magnusnoob/MUP/Hardware.pdf

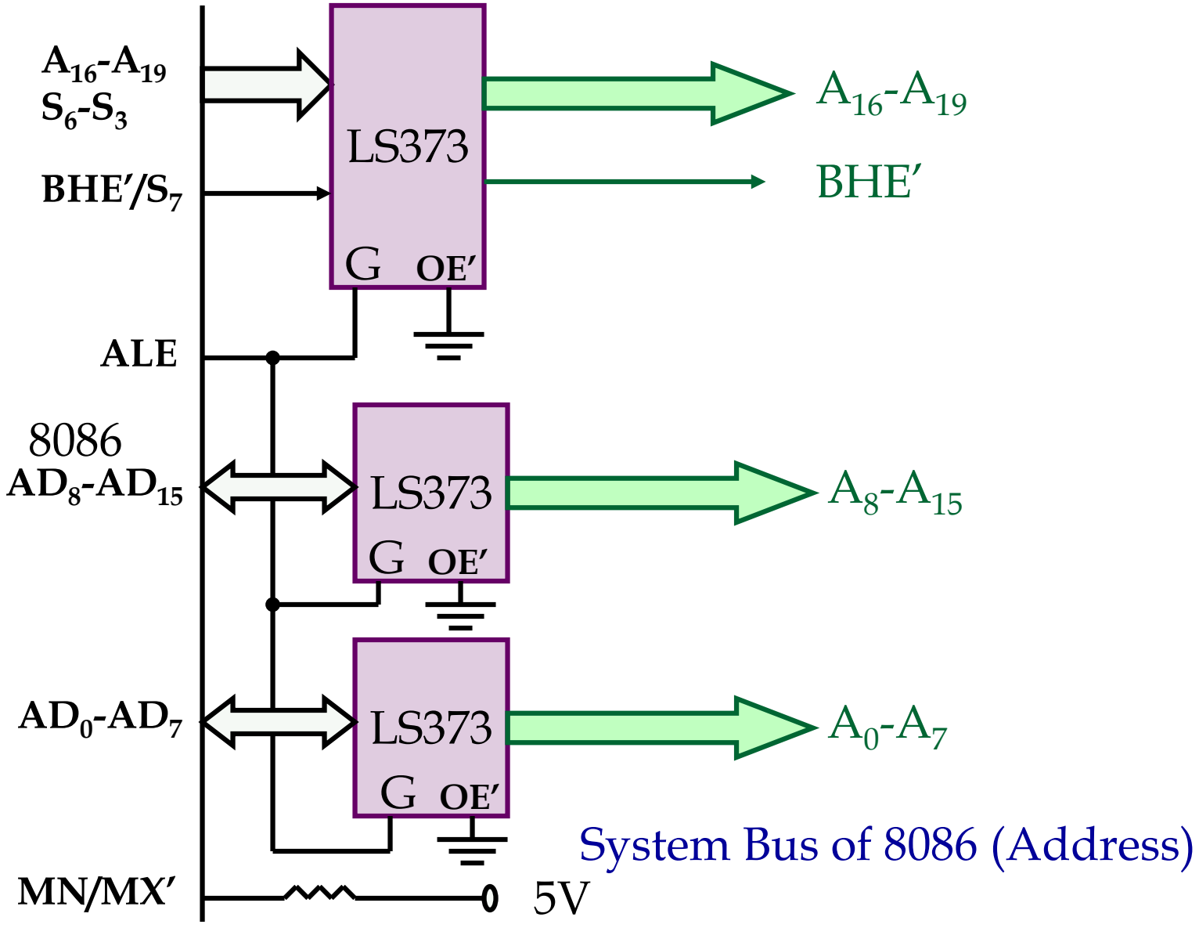
[picture p6: figure]
BHE’/S7; ALE; BHE’; System Bus of 8086 (Address)

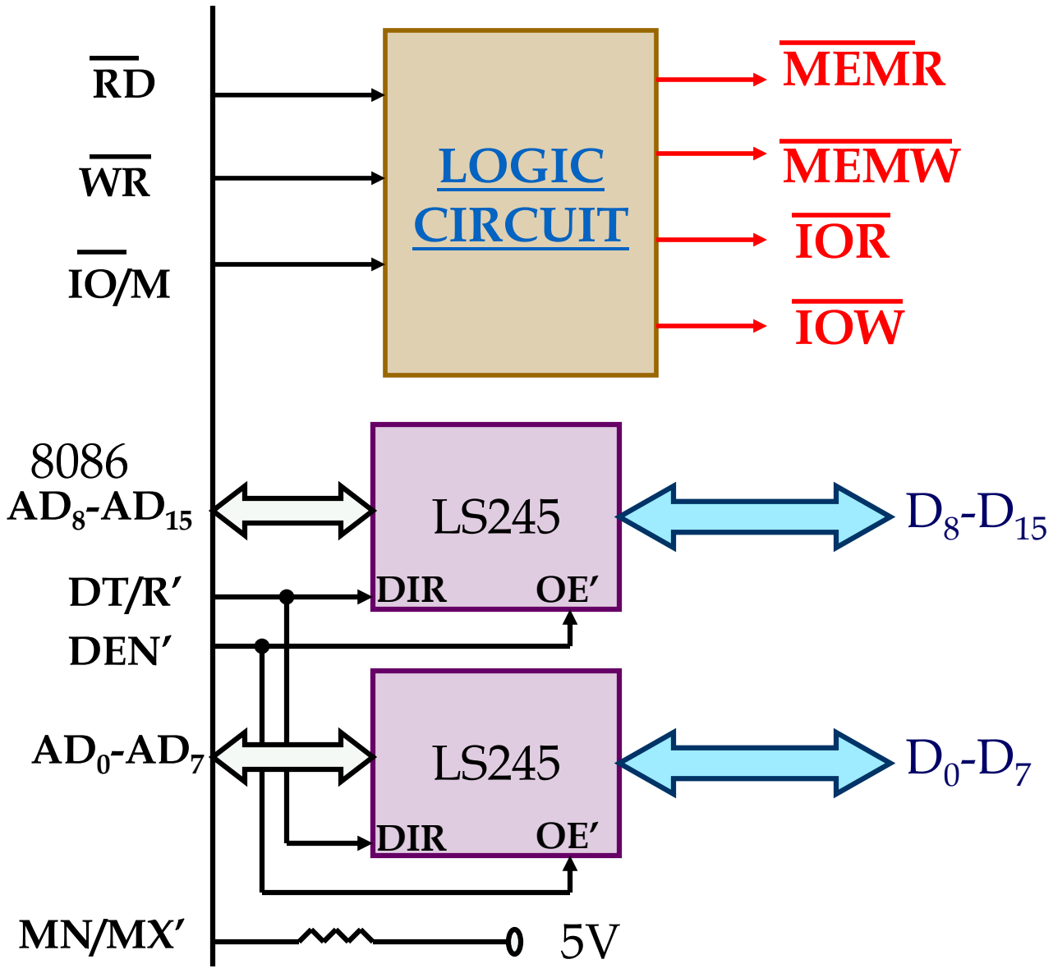
[picture p7: figure]
DIR; DT/R’ DEN’; MEMR; MEMW; IOR; IOW; LOGIC CIRCUIT

System Bus of 8086(Data + Control)

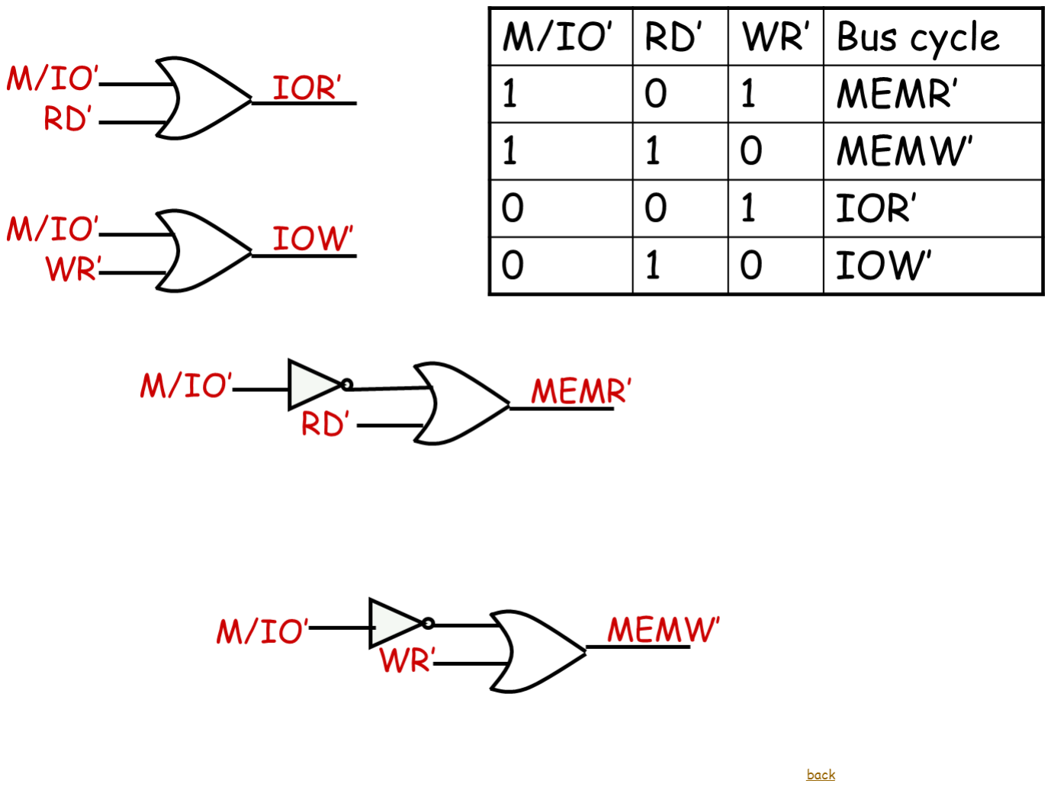
[picture p8: page 3]

LS138

GND

G2A G1

GND G2B

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
MEMW’

BHE’
MEMW’

WRL’

WRH’

Memory Decoder

A0
MEMR’

RDL’

BHE’
MEMR’

RDH’

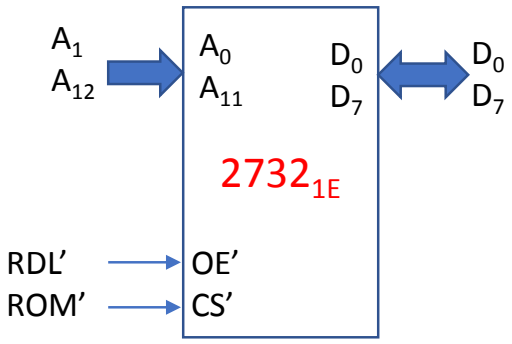
[picture p9: figure]
RDL’ ROM’
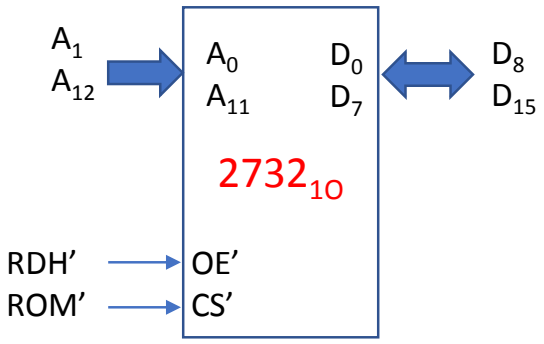
[picture p10: figure]
RDH’ ROM’

Memory Interfacing

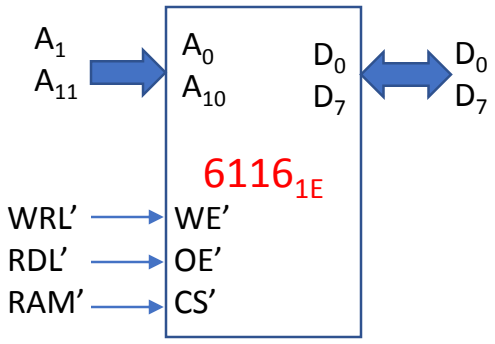
[picture p11: figure]
WRL’ RDL’ RAM’
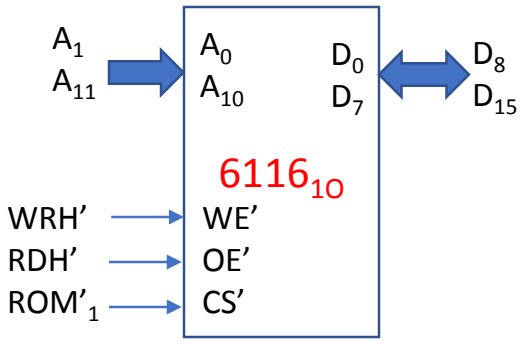
[picture p12: figure]
WRH’ RDH’ ROM’1

LS138

A6

G2A G1

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
8255 C CS’

O0

O3

8255 A CS’

8253 CS’

M/IO

VCC

I/O Decoder

O1

O4
O5
O6

8255 B CS’

8255 D CS’

8255 E CS’
INTCTR

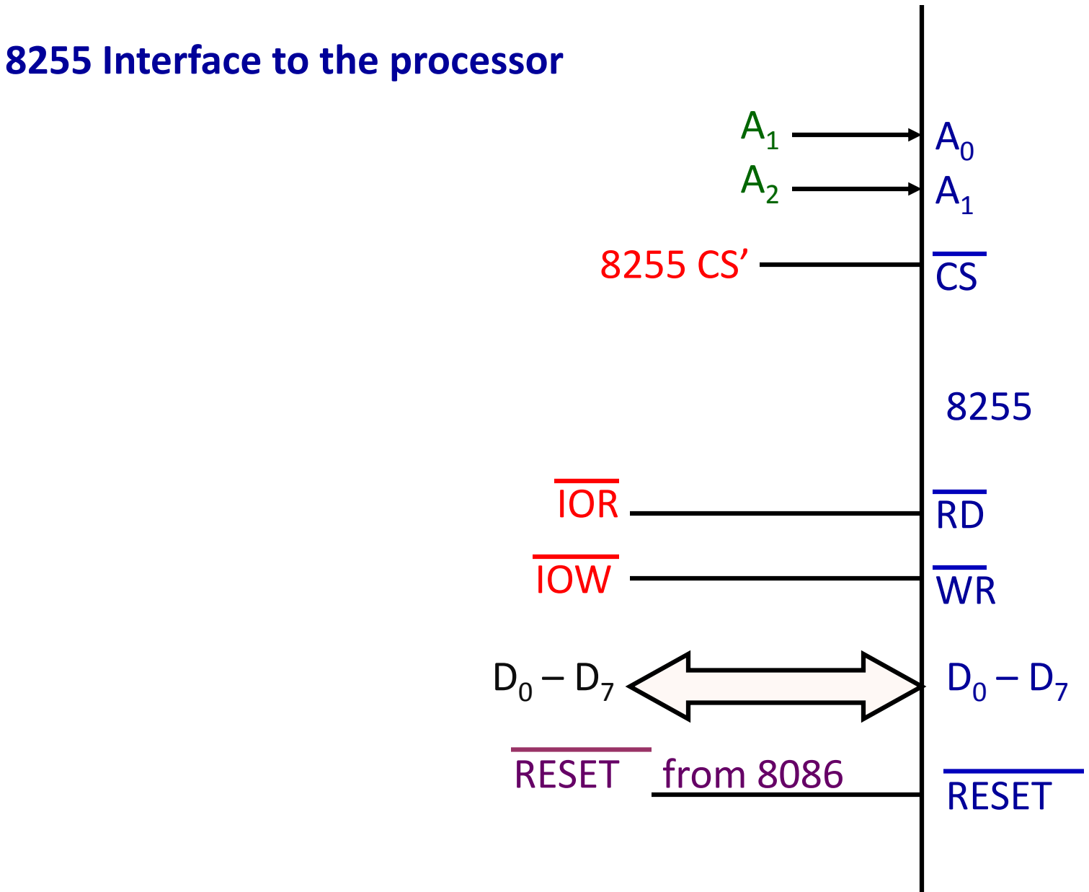
[picture p13: figure]
8255 Interface to the processor; IOR; IOW; RESET RESET from 8086
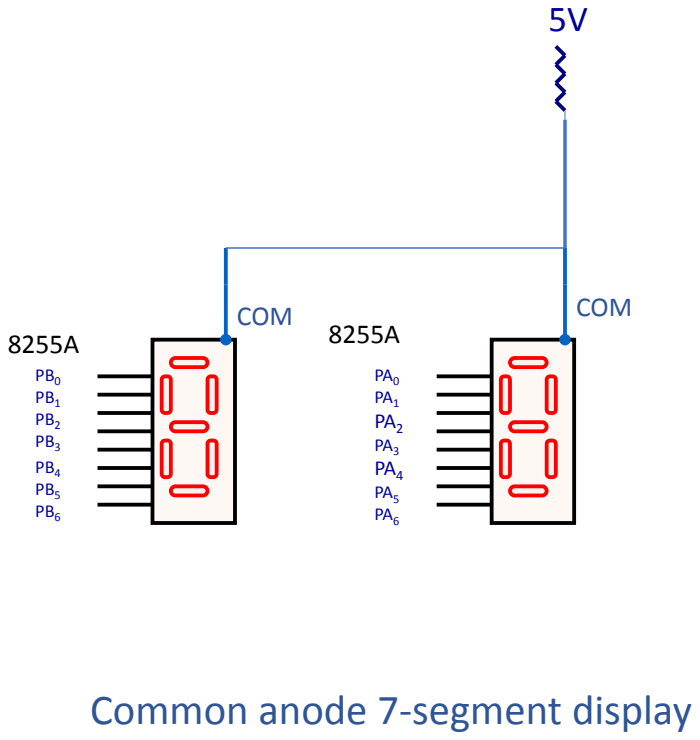
[picture p14: page 8]
COM

Common anode 7-segment display

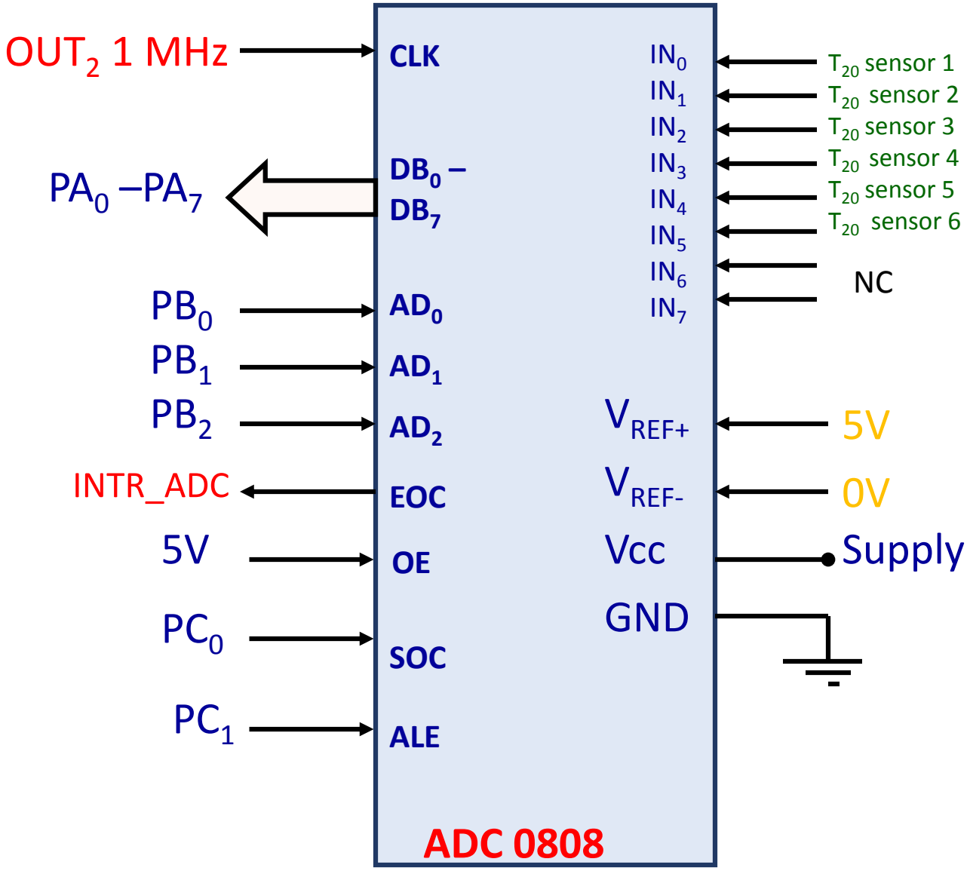
[picture p15: figure]
ADC 0808; T20 sensor 1 T20 sensor 2 T20 sensor 3 T20 sensor 4 T20 sensor 5 T20 sensor 6; OUT2 1 MHz; CLK; VREF+; VREF-; Vcc; GND; Supply; EOC INTR_ADC; SOC; ALE

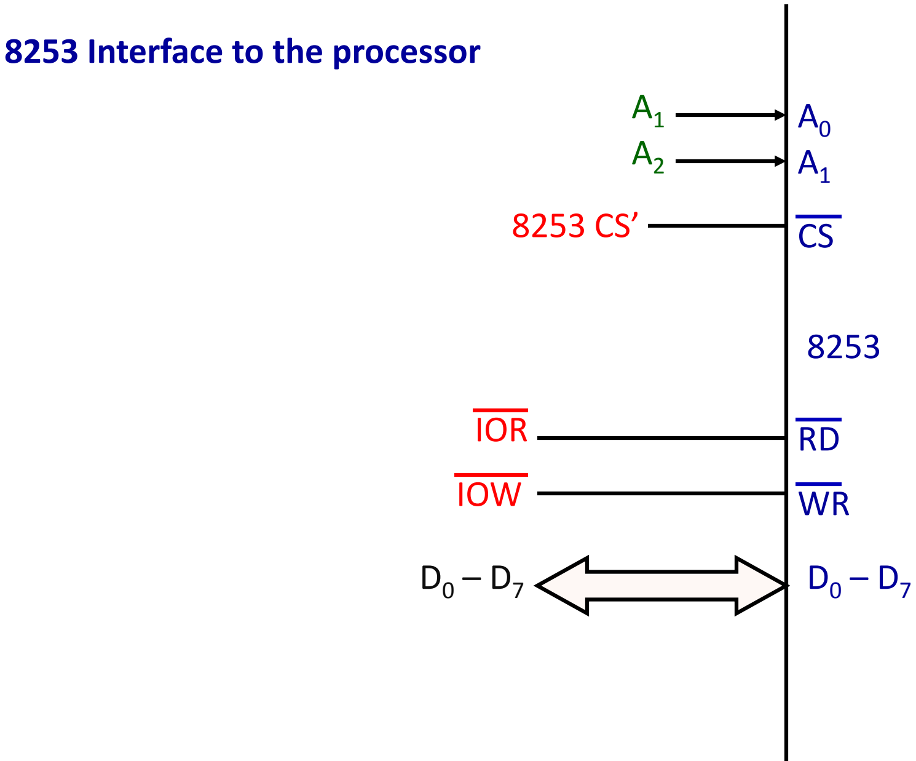
[picture p16: figure]
8253 Interface to the processor; IOR; IOW

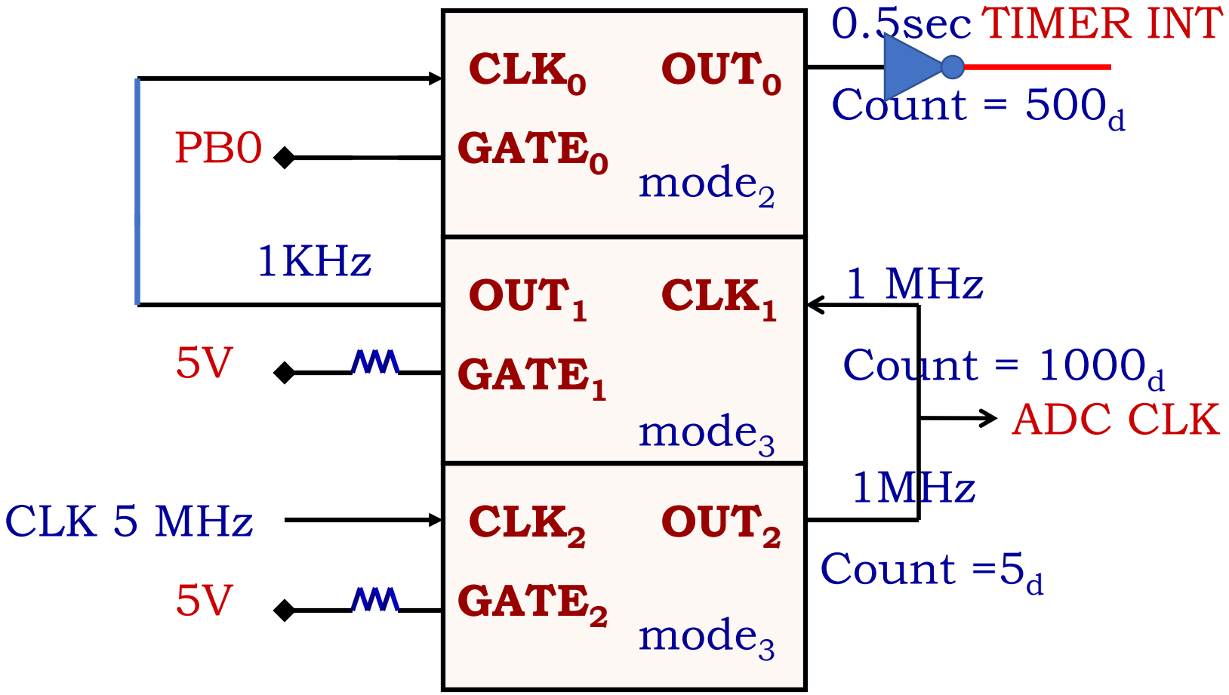
[picture p17: figure]
CLK0; GATE0; OUT0; CLK 5 MHz; OUT1; GATE1; CLK1; 0.5sec; Count = 500d; mode2; mode3; CLK2; GATE2; OUT2; 1MHz; Count =5d; ADC CLK; 1 MHz; Count = 1000d; 1KHz; TIMER INT

8253

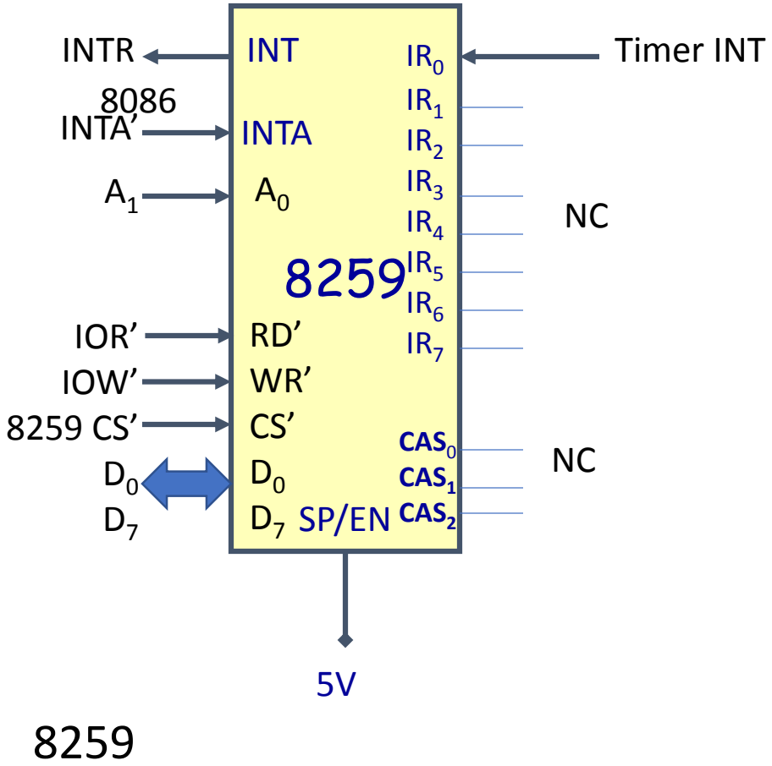
[picture p18: figure]
INT; INTA; CAS0 CAS1; CAS SP/EN; Timer INT; INTR; INTA’; IOR’ IOW’ 8259 CS’ D0 D7

LM35

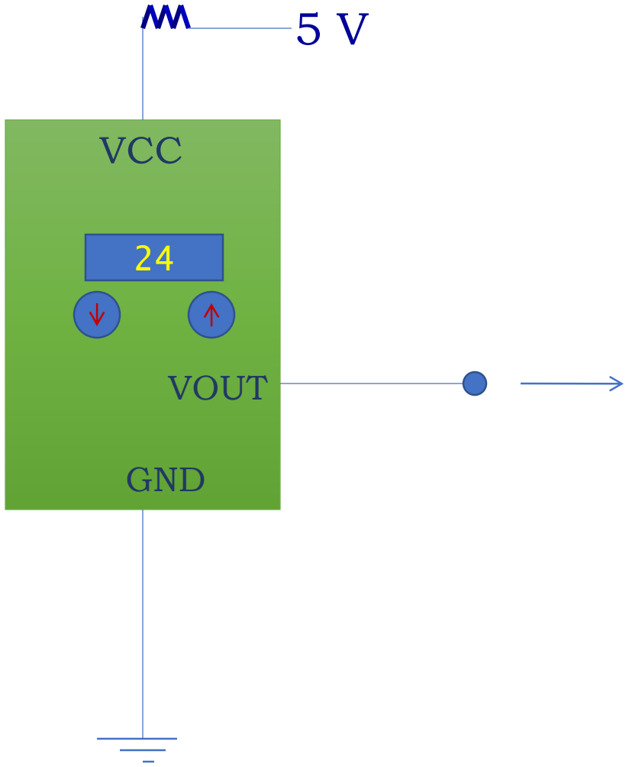
[picture p19: figure]
VCC; GND; VOUT

IN_ADC

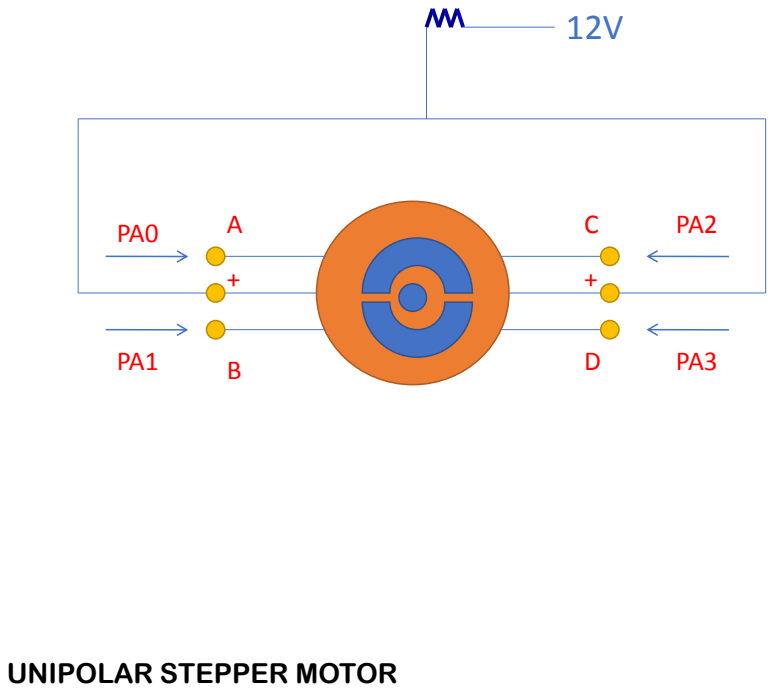
[picture p20: page 14]

UNIPOLAR STEPPER MOTOR

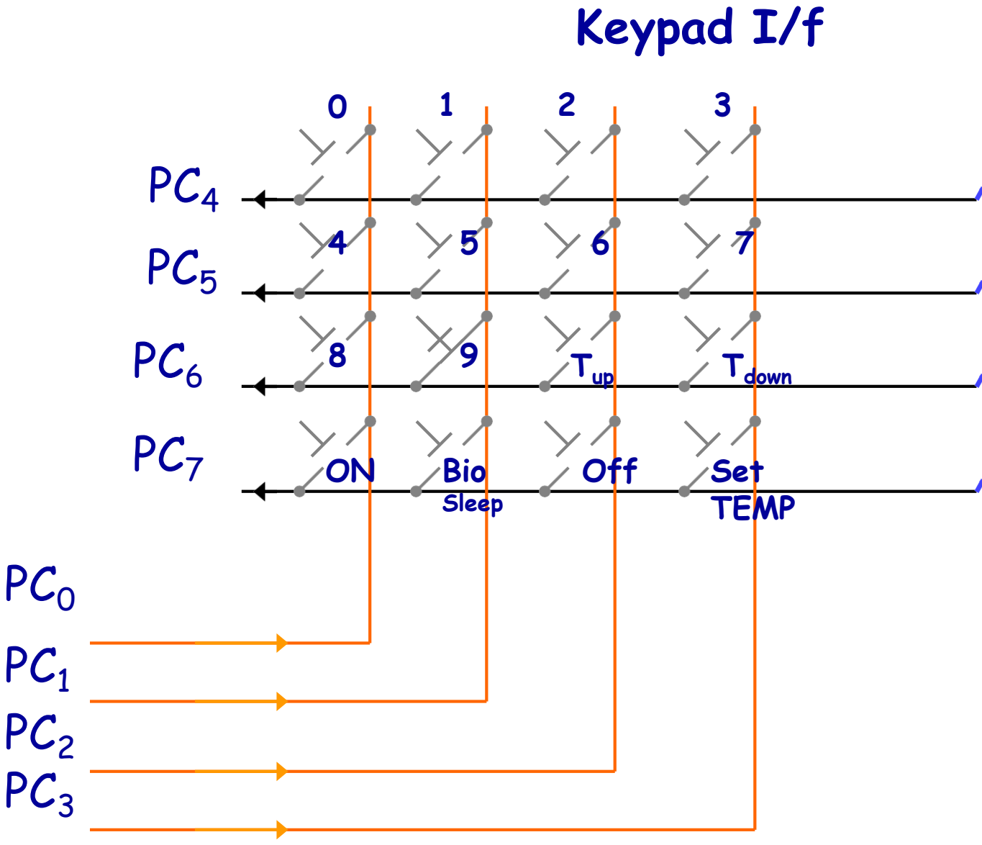
[picture p21: figure]
Keypad I/f Tup; Tdown; Bio; Sleep; Off; Set; TEMP

5V
