magnusnoob/MUP/(list of files, drawings)

Other design files:
Smart_AC-Proteus.pdsprj
